MosyuSora/RapidHistologyPrep/serialTest/build/serialTest/warn-serialTest.txt

This file lists modules PyInstaller was not able to find. This does not
necessarily mean this module is required for running your program. Python and
Python 3rd-party packages include a lot of conditional or optional modules. For
example the module 'ntpath' only exists on Windows, whereas the module
'posixpath' only exists on Posix systems.

Types if import:
* top-level: imported at the top-level - look at these first
* conditional: imported within an if-statement
* delayed: imported within a function
* optional: imported within a try-except-statement

IMPORTANT: Do NOT post this list to the issue-tracker. Use it as a basis for
            tracking down the missing module yourself. Thanks!

missing module named grp - imported by shutil (delayed, optional), tarfile (optional), pathlib (delayed, optional), subprocess (delayed, conditional, optional)
missing module named pwd - imported by posixpath (delayed, conditional, optional), shutil (delayed, optional), tarfile (optional), pathlib (delayed, optional), subprocess (delayed, conditional, optional)
missing module named _frozen_importlib_external - imported by importlib._bootstrap (delayed), importlib (optional), importlib.abc (optional)
excluded module named _frozen_importlib - imported by importlib (optional), importlib.abc (optional)
missing module named posix - imported by os (conditional, optional), shutil (conditional), importlib._bootstrap_external (conditional), posixpath (optional)
missing module named resource - imported by posix (top-level)
missing module named _posixsubprocess - imported by subprocess (conditional)
missing module named fcntl - imported by subprocess (optional), serial.serialposix (top-level)
missing module named pyreadline - imported by C:\Users\mosyu\Desktop\rapid_hist_prep\heatonly\serialTest\serialTest.py (optional)
missing module named startup - imported by pyreadline3.keysyms.common (conditional), pyreadline3.keysyms.keysyms (conditional)
missing module named sets - imported by pyreadline3.keysyms.common (optional)
missing module named System - imported by serial.serialcli (top-level), pyreadline3.keysyms.ironpython_keysyms (top-level), pyreadline3.console.ironpython_console (top-level), pyreadline3.rlmain (conditional)
missing module named console - imported by pyreadline3.console.ansi (conditional)
missing module named clr - imported by pyreadline3.clipboard.ironpython_clipboard (top-level), pyreadline3.console.ironpython_console (top-level)
missing module named IronPythonConsole - imported by pyreadline3.console.ironpython_console (top-level)
missing module named 'System.Windows' - imported by pyreadline3.clipboard.ironpython_clipboard (top-level)
missing module named vms_lib - imported by platform (delayed, optional)
missing module named 'java.lang' - imported by platform (delayed, optional)
missing module named java - imported by platform (delayed)
missing module named _winreg - imported by platform (delayed, optional)
missing module named termios - imported by serial.serialposix (top-level)
missing module named 'System.IO' - imported by serial.serialcli (top-level)
