MosyuSora/RapidHistologyPrep/Schematic Prints.pdf

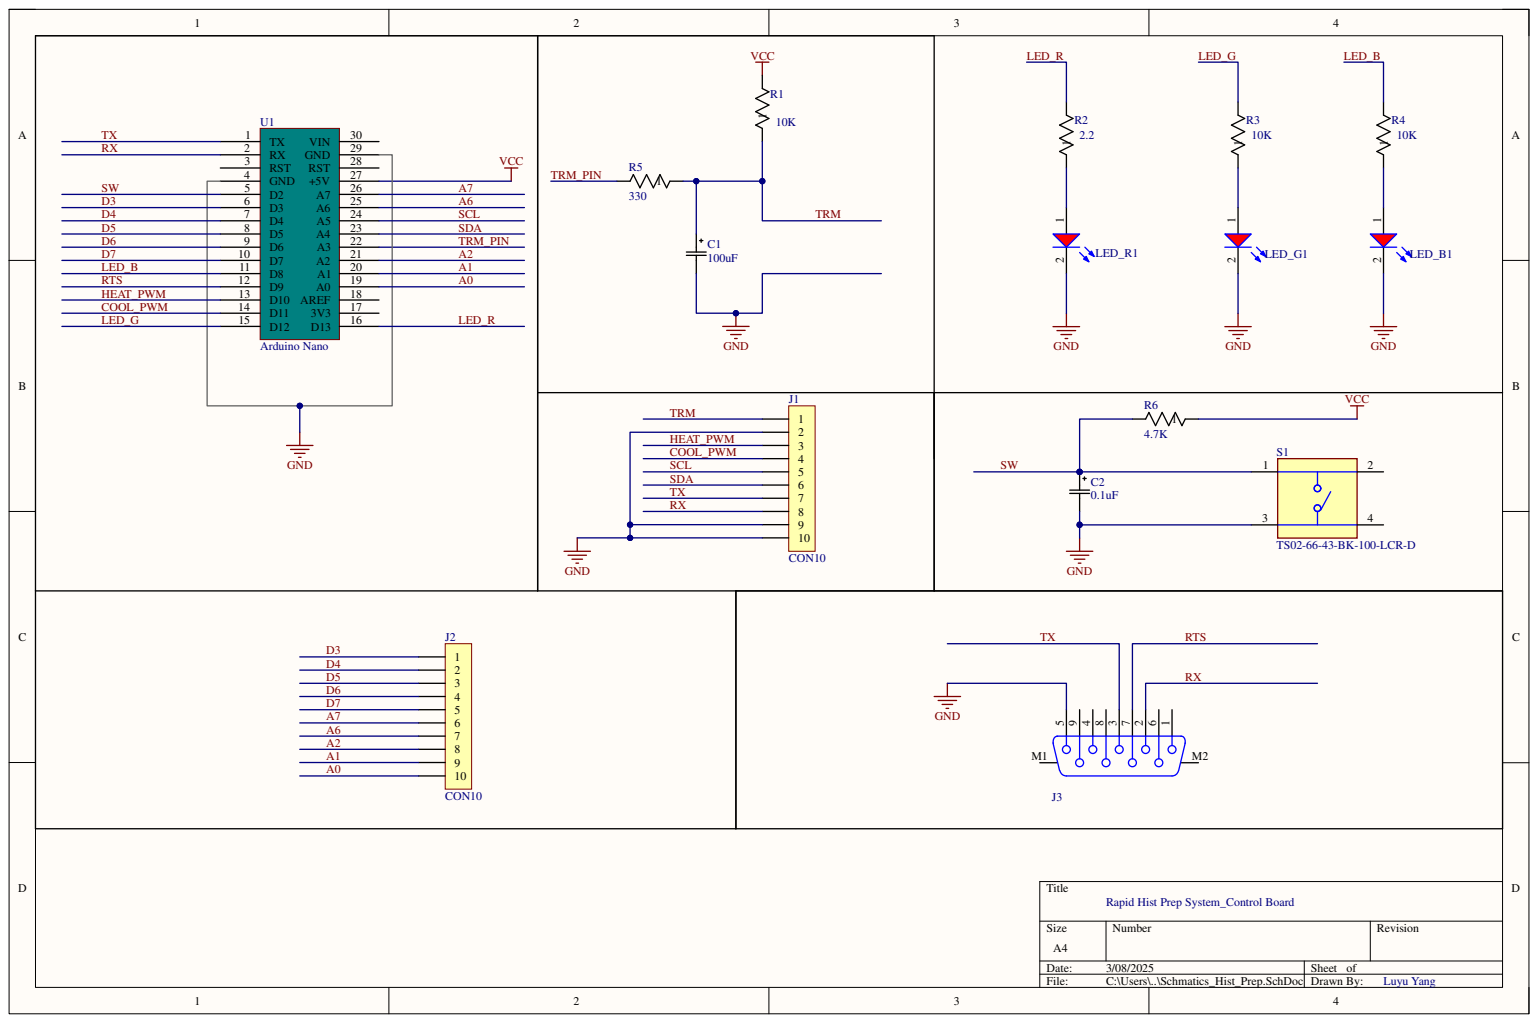
[picture p4: page 1]

Rapid Hist Prep System_Control Board
