MosyuSora/RapidHistologyPrep/(list of files, drawings)

Other design files:
rapid_hist/PCB/PCB_Hist_Prep.PcbDoc
rapid_hist/PCB/Rapid_Hist_Prep.PrjPcb
rapid_hist/PCB/Schmatics_Hist_Prep.SchDoc
