MosyuSora/RapidHistologyPrep/rapid_hist/config.h

#ifndef CONFIG_H
#define CONFIG_H

#include <Arduino.h>

#define BOARD_BTN 2
#define STEP_PIN_1 4
#define DIR_PIN_1 5
#define SLP_PIN_1 6
#define STEP_PIN_2 7
#define DIR_PIN_2 15
#define SLP_PIN_2 16
#define LED_BLUE_PIN 8
#define LED_GREEN_PIN 12
#define LED_RED_PIN 13
#define HEAT_PIN 10
#define COOL_PIN 11
#define THERMISTOR_PIN A3
#define FILTER_SIZE 15
#define STEPS_PER_REV 800
#define LCD_UPDATE_INTERVAL 500

#endif
