MosyuSora/RapidHistologyPrep/(commit log)

2025-02-28 Initial commit: Tremendous refactoring. refactor: - Improved readTemp() by using non-blocking sampling.Removed delay(), improving execution efficiency - Improved PIDcontroller.compute(). Add integral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
    [rapid_hist.ino]
2025-02-28 Add PCB files
    [PCB_Hist_Prep.PcbDoc, Rapid_Hist_Prep.PrjPcb, Schmatics_Hist_Prep.SchDoc]
2025-03-01 feat:blue LED now serves as set-target indicator.^ fix:fixed when serial printing, dutyRatio will print multiple times.
    [rapid_hist.ino]
2025-03-07 feat: Add flow control process >> -Use open-loop method to control reagent adding >> -This version use 2 buttons(1 on PCB, 1 on motorboard) and isolated step-motor drive board
2025-03-09 feat: Uploaded README, uploaded GUI project files, uploaded ancient versions for reference. Now the heating and liquid control state machines interact with each other. Refactor: Adjusted heating logi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
    [T5LCFG.CFG]
2025-03-10 Add schematic file
2025-03-11 - Refined temperature reading logic. - Shortened testing time for quicker validation. - Enhanced serial output with more content. - Added English comments for better readability.
    [rapid_hist.ino]
2025-04-06 Tremendous Update!! - Refractor ALL code to .h/.cpp format - Workable LCD screen!!! - Calibrated thermistor(see Reference\calibration)
    [T5LCFG.CFG, ntc.csv]
2025-04-06 Update Calibration of NTC Thermistor.md
2025-04-08 -fix volume logic(not tested)
    [fluid.cpp, heating.cpp, recipe.h]
2025-04-16 fix some controlling and display bugs.
    [fluid.cpp, heating.cpp, rapid_hist.ino, serial_lcd.cpp, serial_lcd.h]
